LostSpeed/krgy_juki_holder_user_manual/to_user/高精度juki吸嘴快拆连接器铜套座-v8-UM03_吸嘴坞设计参考文件/说明.txt

拼装吸嘴坞的子零件:
	V11_吸嘴坞_安装底板.SLDPRT
	V11_吸嘴坞_独立单元.SLDPRT
	V11_吸嘴坞_左端墙.SLDPRT
	V11_吸嘴坞_右端墙.SLDPRT
	V11_吸嘴坞_占位调整片.SLDPRT

拼装好的吸嘴坞例子工程
	装配体_拼装后的吸嘴坞.SLDASM
	装配体_拼装后的吸嘴坞.SLDPRT

测试工装
	V11_吸嘴坞_入坞高度检测工装.SLDPRT
	V11_吸嘴坞_脱离高度测试工装.SLDPRT
	零件_Z轴倾斜度平面坐标测试工装_v2.SLDPRT

装配模拟用的吸嘴模型的工程文件
	juki503_v1_磁吸高度5mm.SLDPRT	

如果您自己修改拼装适合您设备的吸嘴坞，请参考文档<<高精度juki吸嘴快拆连接器铜套座-v8-UM03_吸嘴坞设计参考文件.pdf>>
如果您自己修改拼装适合您设备的吸嘴坞，而没有solidworks2025的安装包，请向我公司索要安装包
如果您不方便亲手制作专用吸嘴坞，我公司为您免费制作吸嘴坞，需要您告诉我们尺寸(螺丝孔，周边限位空间)，请参考文档<<高精度juki吸嘴快拆连接器铜套座-v8-UM03_吸嘴坞设计参考文件.pdf>>
