LostSpeed/krgy_juki_holder_user_manual/to_user/高精度juki吸嘴快拆连接器铜套座-v8-UM05_公司淘宝店地址.pdf

# 高精度juki吸嘴快拆连接器铜套座-v8-UM05_ 公司淘宝店地址

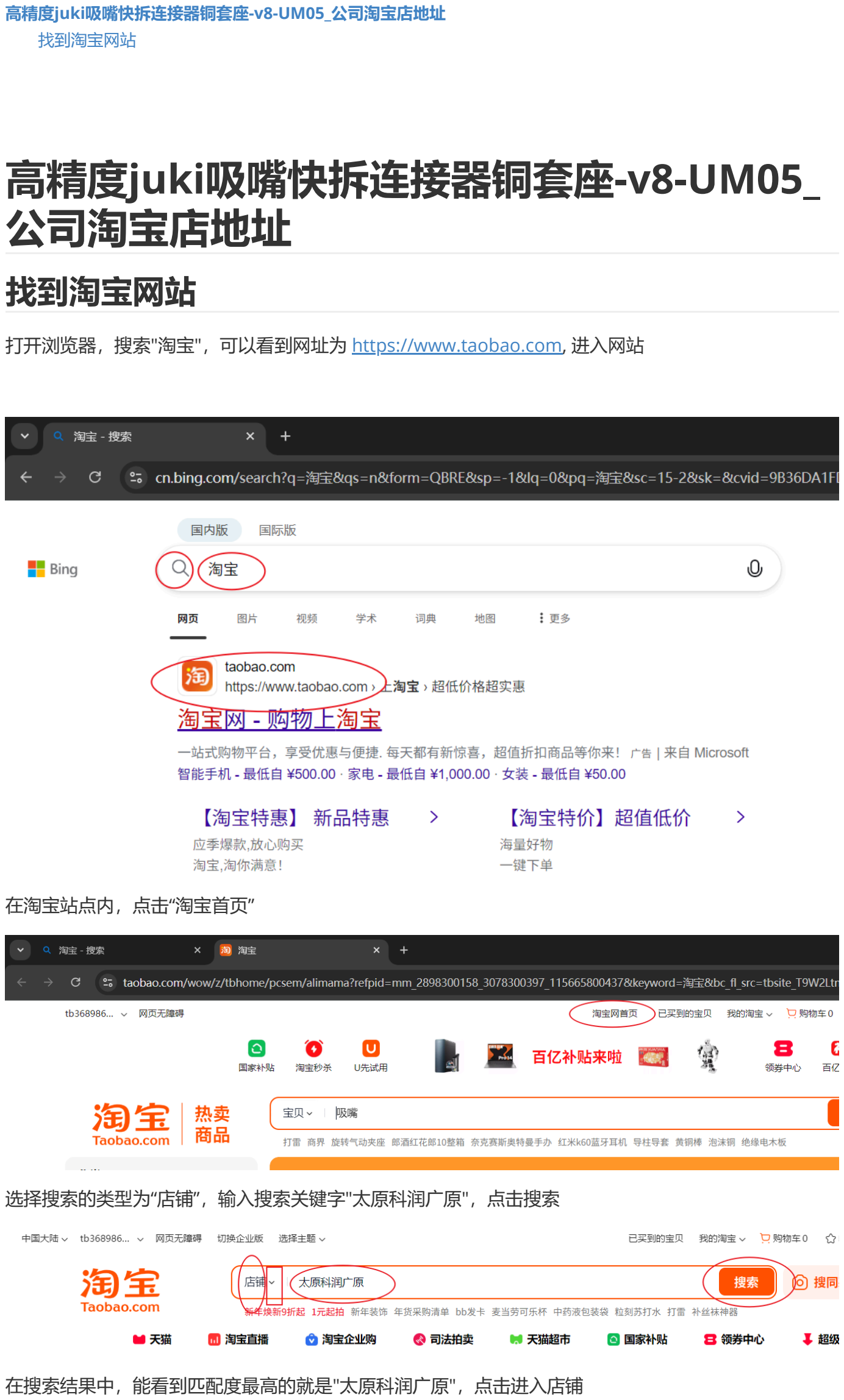
[picture p35: page 1]

高精度juki吸嘴快拆连接器铜套座-v8-UM05_公司淘宝店地址 找到淘宝网站

# 找到淘宝网站

打开浏览器，搜索"淘宝"，可以看到网址为 https://www.taobao.com, 进入网站

在淘宝站点内，点击“淘宝首页”

选择搜索的类型为“店铺”，输入搜索关键字"太原科润广原"，点击搜索

在搜索结果中，能看到匹配度最高的就是"太原科润广原"，点击进入店铺

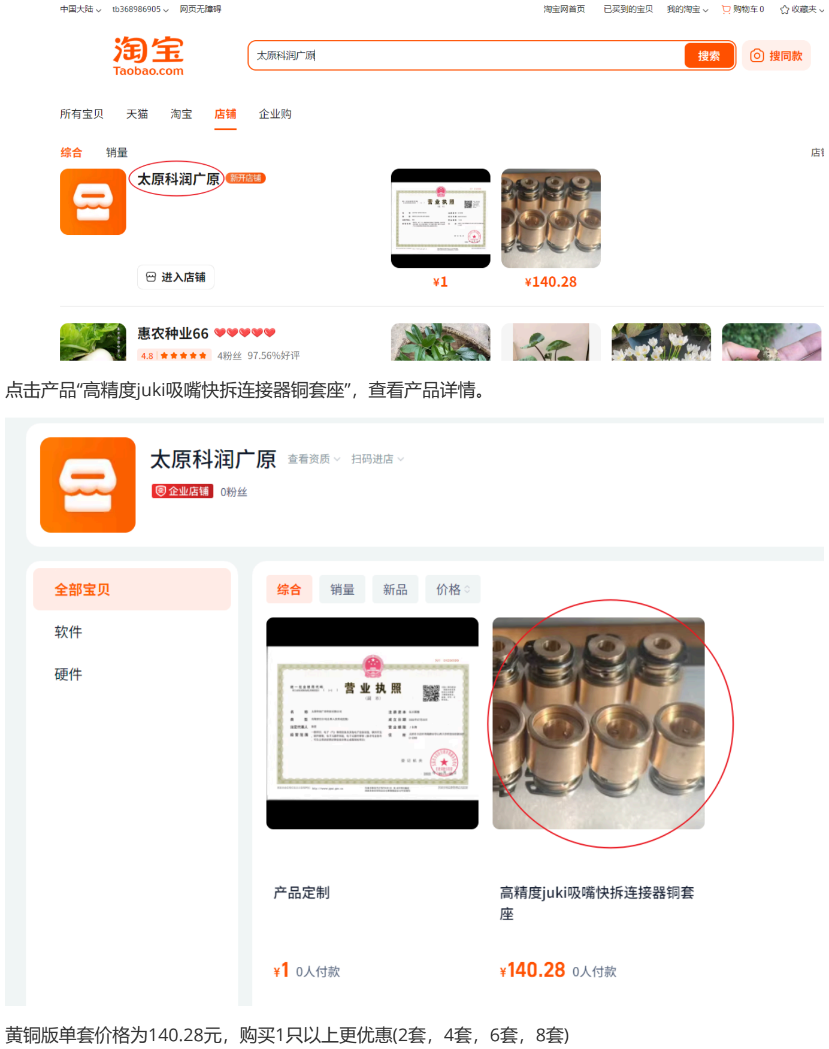
[picture p36: page 2]

点击产品“高精度juki吸嘴快拆连接器铜套座”，查看产品详情。

黄铜版单套价格为140.28元，购买1只以上更优惠(2套，4套，6套，8套)

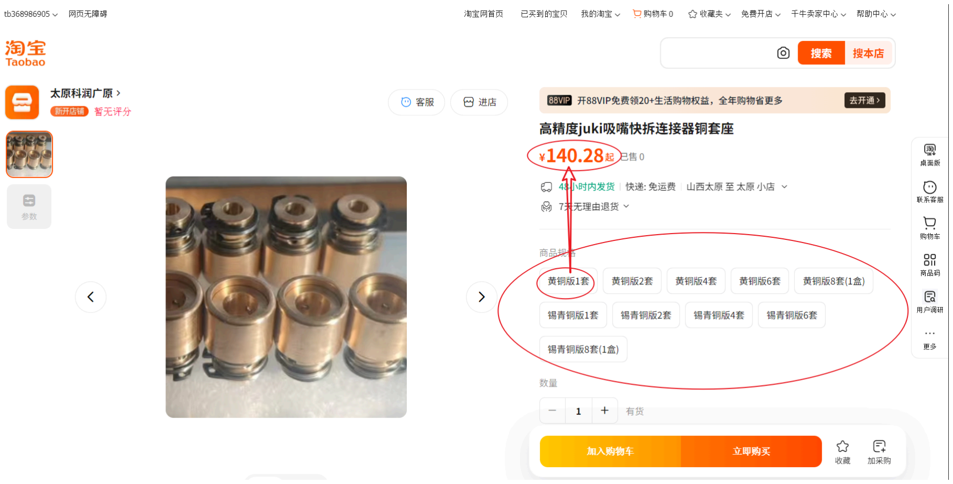
[picture p37: figure]
