LostSpeed/krgy_juki_holder_user_manual/to_user/高精度juki吸嘴快拆连接器铜套座-v8-UM03_吸嘴坞设计参考文件/装配体_拼装后的吸嘴坞.SLDASM

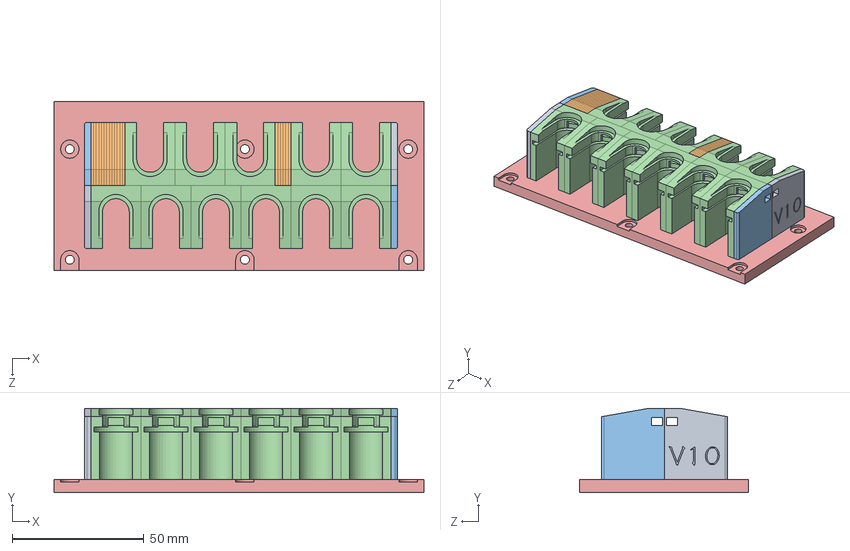
[picture p38: CAD file, 2026-01-03]
to_user/高精度juki吸嘴快拆连接器铜套座-v8-UM03_吸嘴坞设计参考文件/装配体_拼装后的吸嘴坞.SLDASM
140.5 x 32.0 x 64.0 mm
V11_吸嘴坞_安装底板
V11_吸嘴坞_独立单元 x 11
V11_吸嘴坞_右端墙 x 2
V11_吸嘴坞_占位调整片 x 19
V11_吸嘴坞_左端墙 x 2
