LostSpeed/krgy_juki_holder_user_manual/to_user/高精度juki吸嘴快拆连接器铜套座-v8-UM03_吸嘴坞设计参考文件/V11_吸嘴坞_占位调整片.SLDPRT

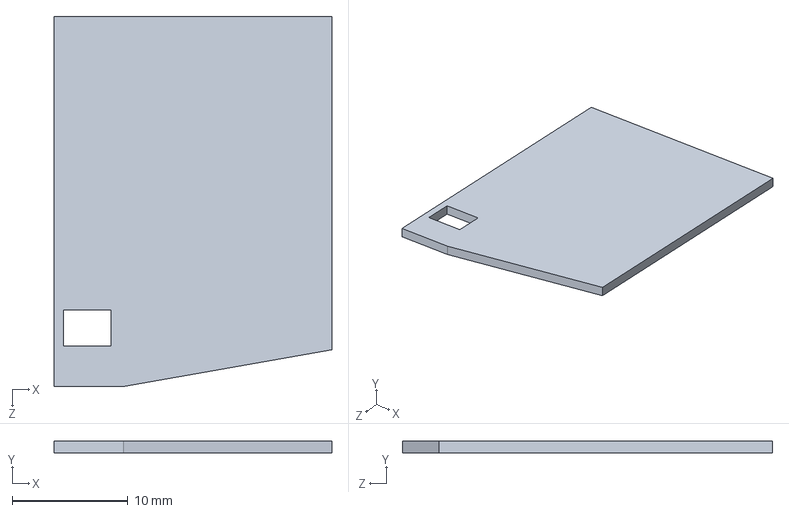
[picture p39: CAD file, 2026-01-03]
to_user/高精度juki吸嘴快拆连接器铜套座-v8-UM03_吸嘴坞设计参考文件/V11_吸嘴坞_占位调整片.SLDPRT
24.0 x 1.00 x 32.0 mm
