LostSpeed/krgy_juki_holder_user_manual/to_user/高精度juki吸嘴快拆连接器铜套座-v8-UM03_吸嘴坞设计参考文件/V11_吸嘴坞_安装底板.SLDPRT

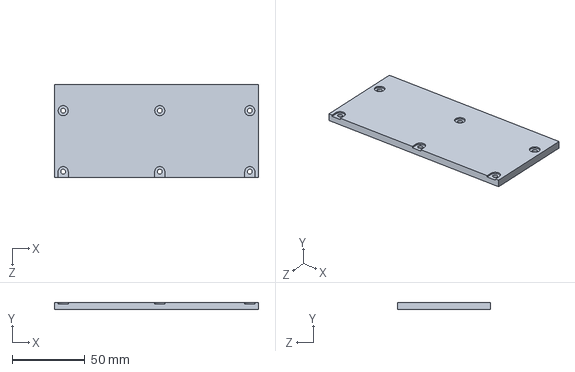
[picture p40: CAD file, 2026-01-03]
to_user/高精度juki吸嘴快拆连接器铜套座-v8-UM03_吸嘴坞设计参考文件/V11_吸嘴坞_安装底板.SLDPRT
140.5 x 5.00 x 64.0 mm
