LostSpeed/krgy_juki_holder_user_manual/to_user/高精度juki吸嘴快拆连接器铜套座-v8-UM03_吸嘴坞设计参考文件/juki503_v1_磁吸高度5mm.SLDPRT

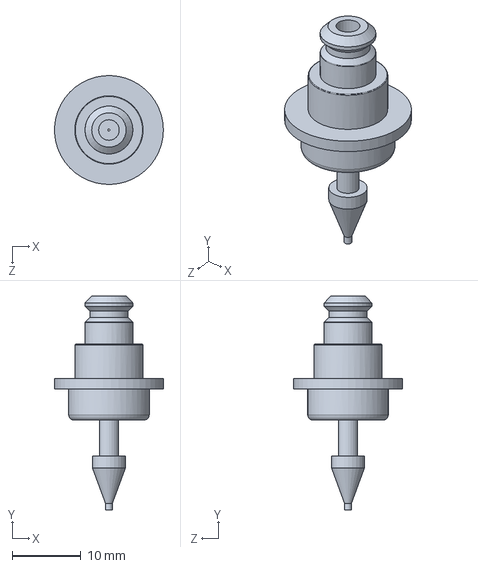
[picture p41: CAD file, 2026-01-03]
to_user/高精度juki吸嘴快拆连接器铜套座-v8-UM03_吸嘴坞设计参考文件/juki503_v1_磁吸高度5mm.SLDPRT
15.8 x 31.1 x 15.8 mm
