LostSpeed/krgy_juki_holder_user_manual/to_user/高精度juki吸嘴快拆连接器铜套座-v8-UM03_吸嘴坞设计参考文件/零件_Z轴倾斜度平面坐标测试工装_v2.SLDPRT

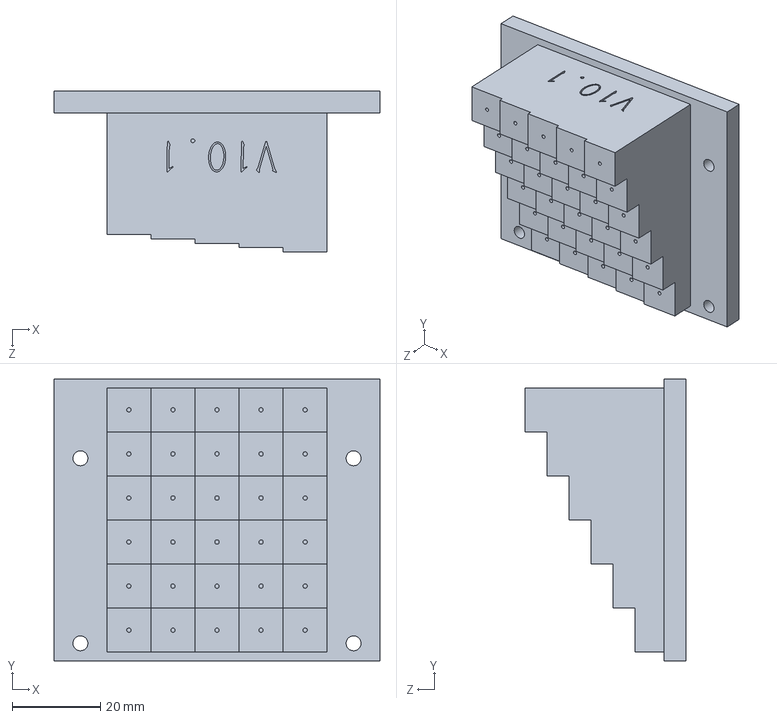
[picture p42: CAD file, 2026-01-03]
to_user/高精度juki吸嘴快拆连接器铜套座-v8-UM03_吸嘴坞设计参考文件/零件_Z轴倾斜度平面坐标测试工装_v2.SLDPRT
74.0 x 64.0 x 36.6 mm
