LostSpeed/krgy_juki_holder_user_manual/(list of files, cad)

Other CAD files:
to_user/高精度juki吸嘴快拆连接器铜套座-v8-UM03_吸嘴坞设计参考文件/装配体_拼装后的吸嘴坞.SLDPRT
