LostSpeed/krgy_juki_holder_user_manual/(commit log)

2026-01-03 add doc
    [V11_吸嘴坞_入坞高度检测工装.SLDPRT, V11_吸嘴坞_占位调整片.SLDPRT, V11_吸嘴坞_右端墙.SLDPRT, V11_吸嘴坞_安装底板.SLDPRT, V11_吸嘴坞_左端墙.SLDPRT, V11_吸嘴坞_独立单元.SLDPRT, V11_吸嘴坞_脱离高度测试工装.SLDPRT, juki503_v1_磁吸高度5mm.SLDPRT]
2026-01-05 增加产品购买连接
